usbalbin/hw-half-bridge/controller/controller.png

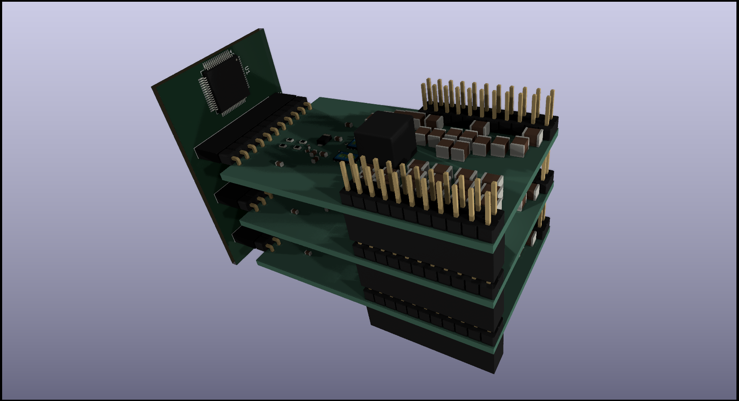
controller/controller.png
