usbalbin/hw-half-bridge/controller/controller2.png

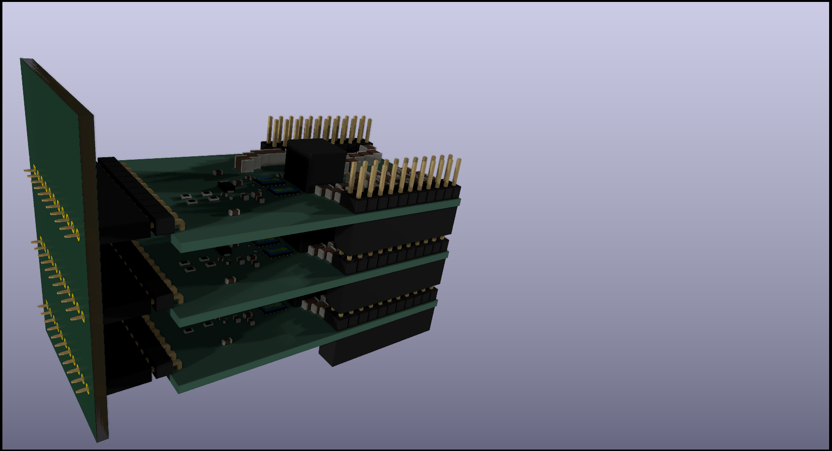
controller/controller2.png
