usbalbin/hw-half-bridge/3d/Alps/RK09Y11L0001.STEP

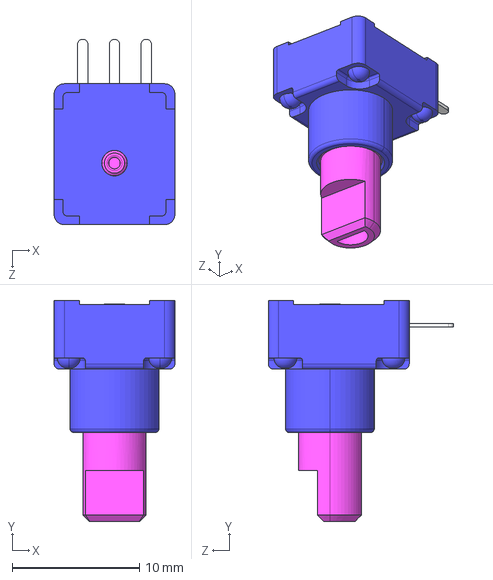
[picture p3: CAD file, 2024-12-15]
3d/Alps/RK09Y11L0001.STEP
9.50 x 17.4 x 14.6 mm
