usbalbin/hw-half-bridge/3d/Cree LED/CLMUD-FKC-CH1NP1561BB7T4S3.stp

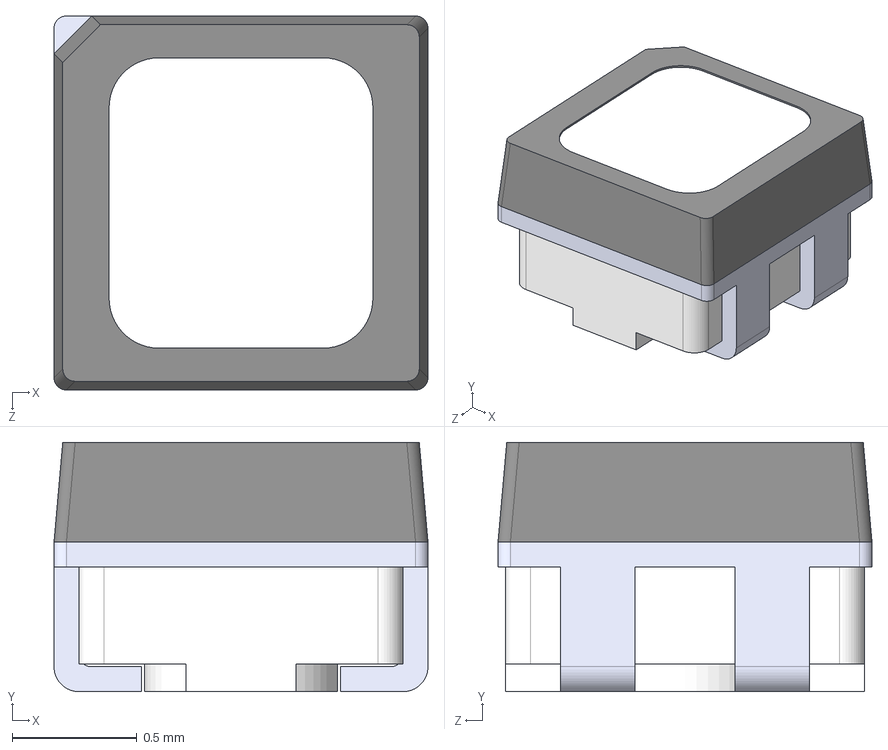
[picture p4: CAD file, 2024-12-15]
3d/Cree LED/CLMUD-FKC-CH1NP1561BB7T4S3.stp
1.50 x 1.00 x 1.50 mm
