usbalbin/hw-half-bridge/3d/kemet/C1210C474KARACAUTO.step

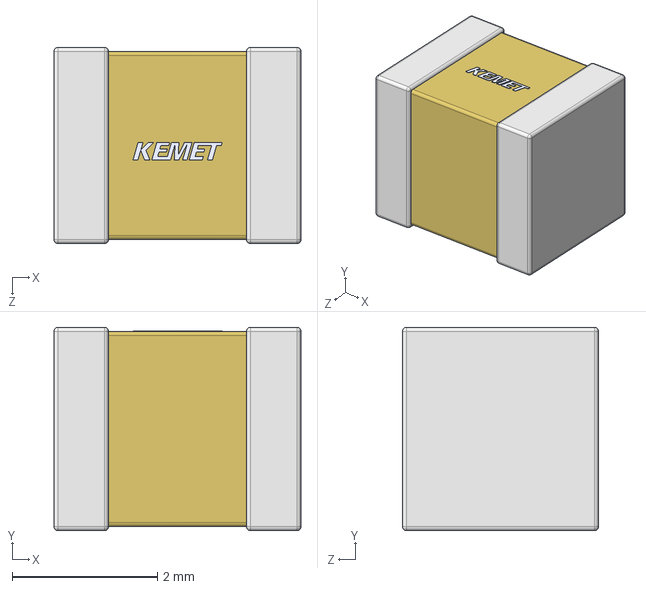
[picture p6: CAD file, 2024-06-02]
3d/kemet/C1210C474KARACAUTO.step
3.40 x 2.80 x 2.70 mm
