usbalbin/hw-half-bridge/3d/ohmite/FCSL20R005FER.stp

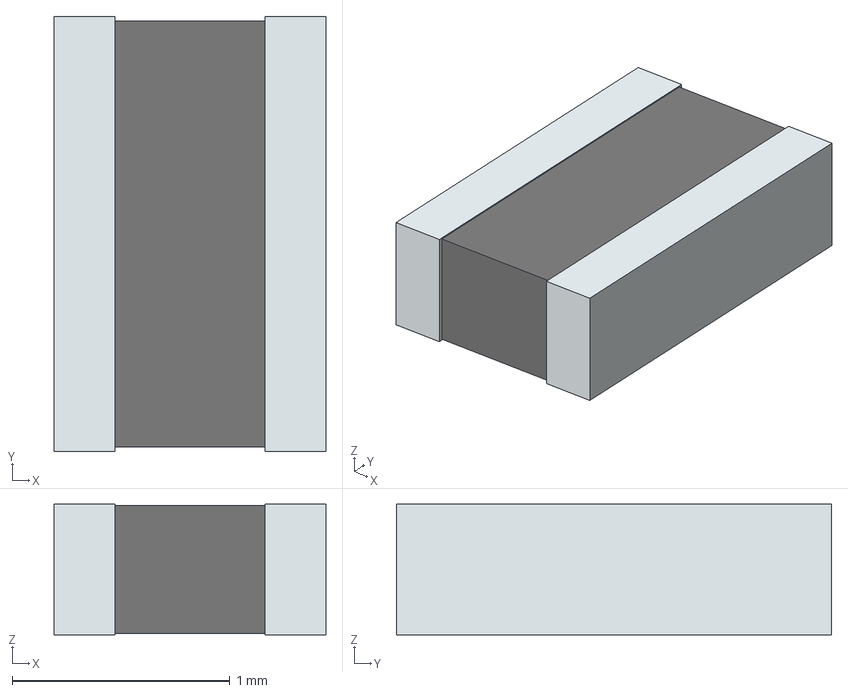
[picture p7: CAD file, 2024-06-02]
3d/ohmite/FCSL20R005FER.stp
1.25 x 2.00 x 0.6 mm
term1
term2
