usbalbin/hw-half-bridge/3d/STM/QFN-6L_STM.step

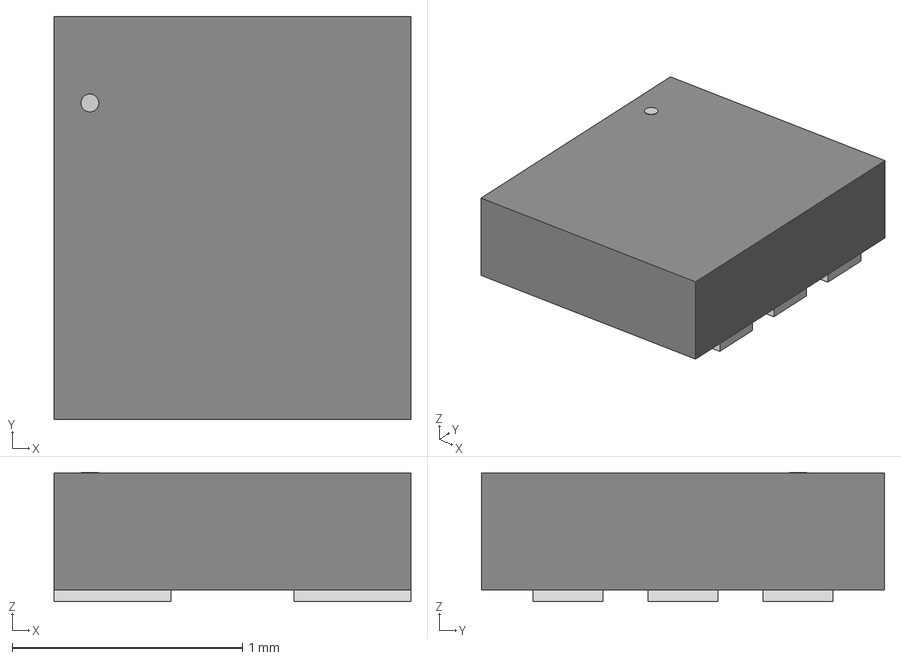
[picture p8: CAD file, 2024-12-15]
3d/STM/QFN-6L_STM.step
1.55 x 1.75 x 0.561 mm
