usbalbin/hw-half-bridge/3d/TDK/CLF7045NIT-4R7N-D.STEP

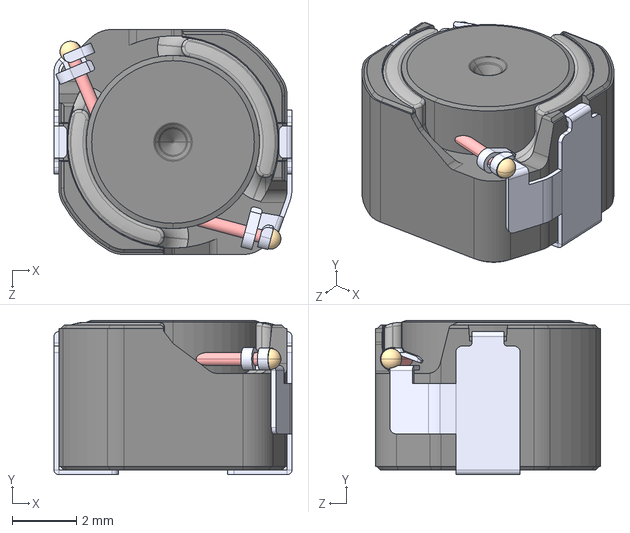
[picture p9: CAD file, 2024-12-15]
3d/TDK/CLF7045NIT-4R7N-D.STEP
7.40 x 4.80 x 7.00 mm
