usbalbin/hw-half-bridge/3d/texas/RVR0019A.stp

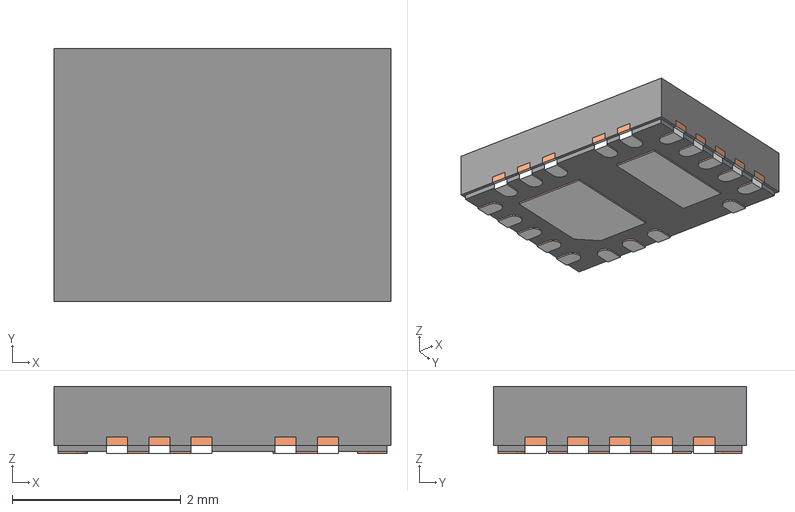
[picture p10: CAD file, 2024-06-02]
3d/texas/RVR0019A.stp
4.00 x 3.00 x 0.8 mm
BODY-QFN_AF0
FRAME-RVR0019A_AF0
PIN1-ID
