usbalbin/hw-half-bridge/heat-spreader/heat_spreader2.FCStd

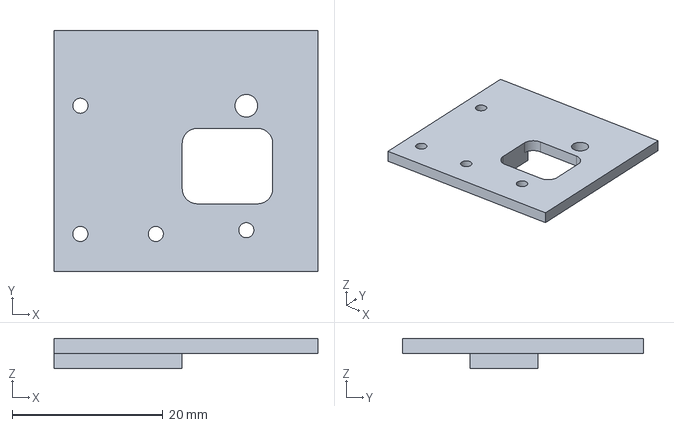
[picture p11: CAD file, 2025-07-12]
heat-spreader/heat_spreader2.FCStd
35.0 x 32.0 x 4.00 mm
