usbalbin/hw-half-bridge/3d/Alps/EC11E-05SW.STEP

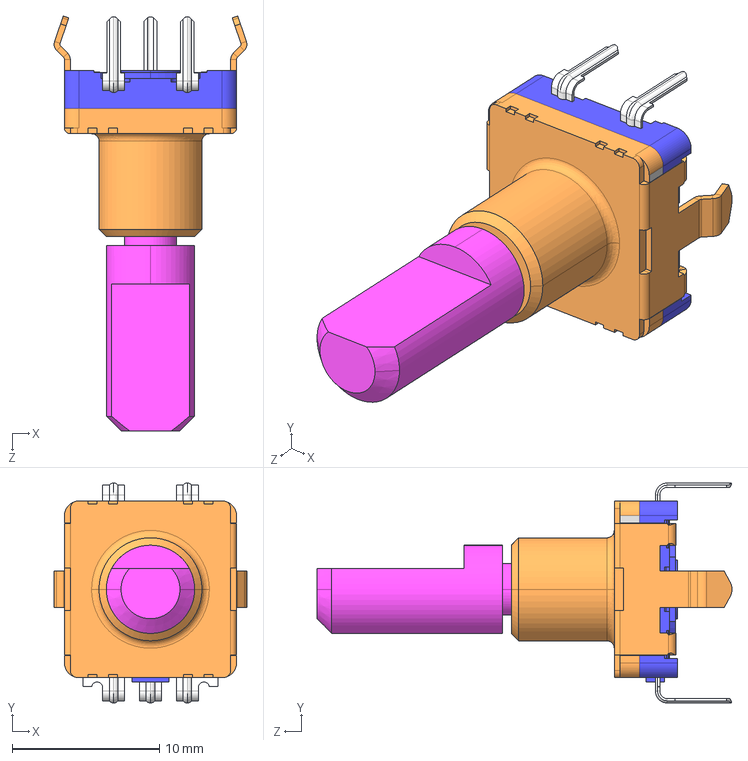
[picture p12: CAD file, 2024-12-15]
3d/Alps/EC11E-05SW.STEP
13.1 x 15.0 x 28.2 mm
