usbalbin/hw-half-bridge/heat-spreader/heat_spreader.FCStd

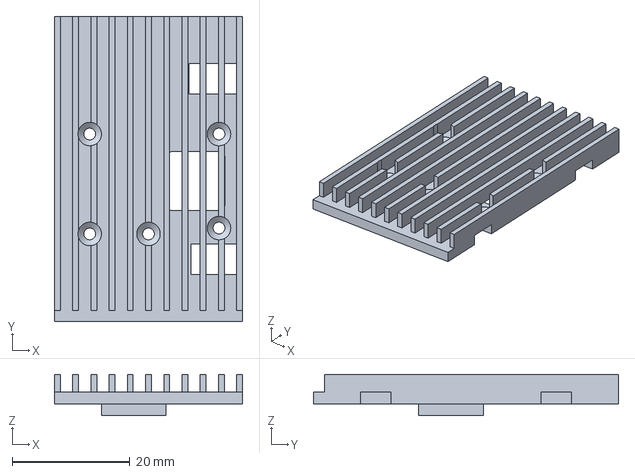
[picture p13: CAD file, 2024-06-02]
heat-spreader/heat_spreader.FCStd
32.0 x 51.9 x 7.00 mm
