usbalbin/hw-half-bridge/3d/Allegro/ACS37030LLZATR-020B3.stp

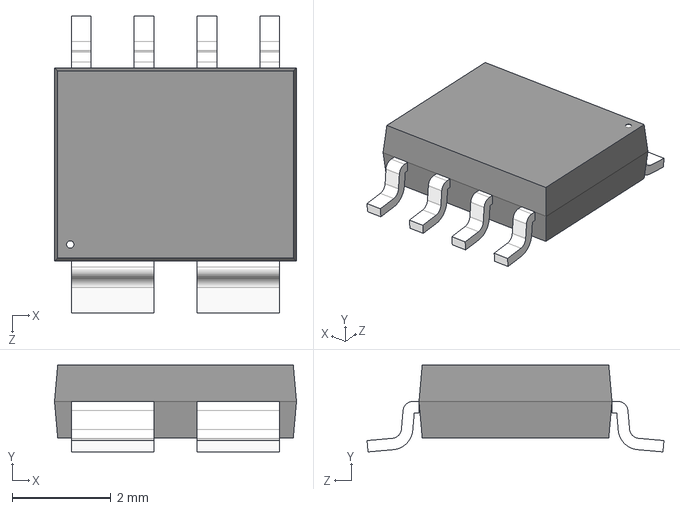
[picture p14: CAD file, 2024-12-15]
3d/Allegro/ACS37030LLZATR-020B3.stp
4.89 x 1.75 x 6.00 mm
