usbalbin/hw-half-bridge/(threads)

Thread 11 (2025-06-15):

Tests

usbalbin, 2025-06-15:
With 10ohm gate resistors

* f_sw: 1MHz (yes this should be reduced I know)
* t_dt: 21ns deadtime
* r_load: 4ohm load
* v_in: 20v
* D: ramping 20-90% "sawtooth" with about 10s period
* I_in max 3.2A at 90%
* Temp: high side FET hurts a bit to touch (camera says about 60). Will probably get too hot at constant 90%. You can feel the cange in temp during the ramp.

Looking at [EPC buck tool](https://epc-co.com/epc/design-support/tools-and-calculators/gan-power-bench/gan-fet-selection-tool-for-buck-convertors) the losses of the high side FET should be 459mW with 261mW being due to Poss. Reducing the gate resistors to 1ohm would in theory give us 375mW. Also the low side losses are more or less dominated by the deadtime losses.

TODO:
* [ ] Check gate wave forms
* [ ] How low can we go with the deadtime
* [ ] Ringing?
* [ ] Reduce gate resistors? 1ohm?
* [ ] Repeat

Test lower f_sw
Test lower r_load and lower v_in
