usbalbin/hw-half-bridge/controller/controller.kicad_pcb

## KiCad design controller/controller.kicad_pcb (2024-12-15)

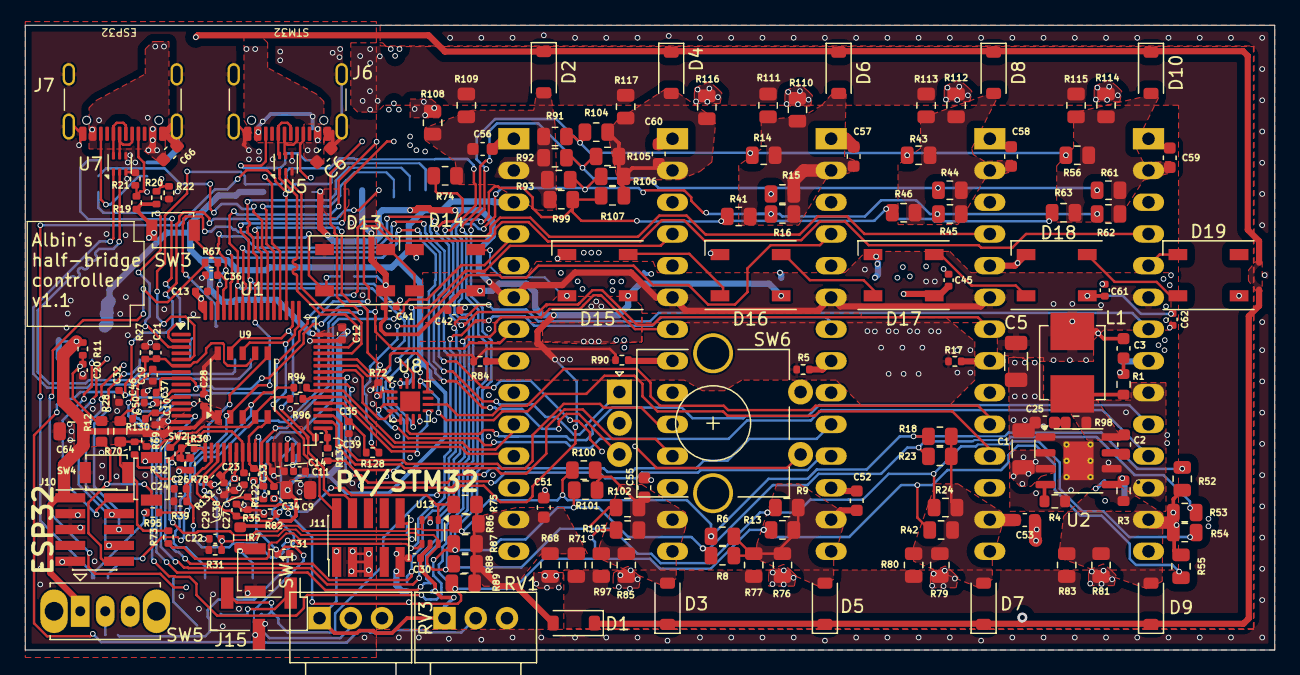
[picture p15: board controller.kicad_pcb from above]

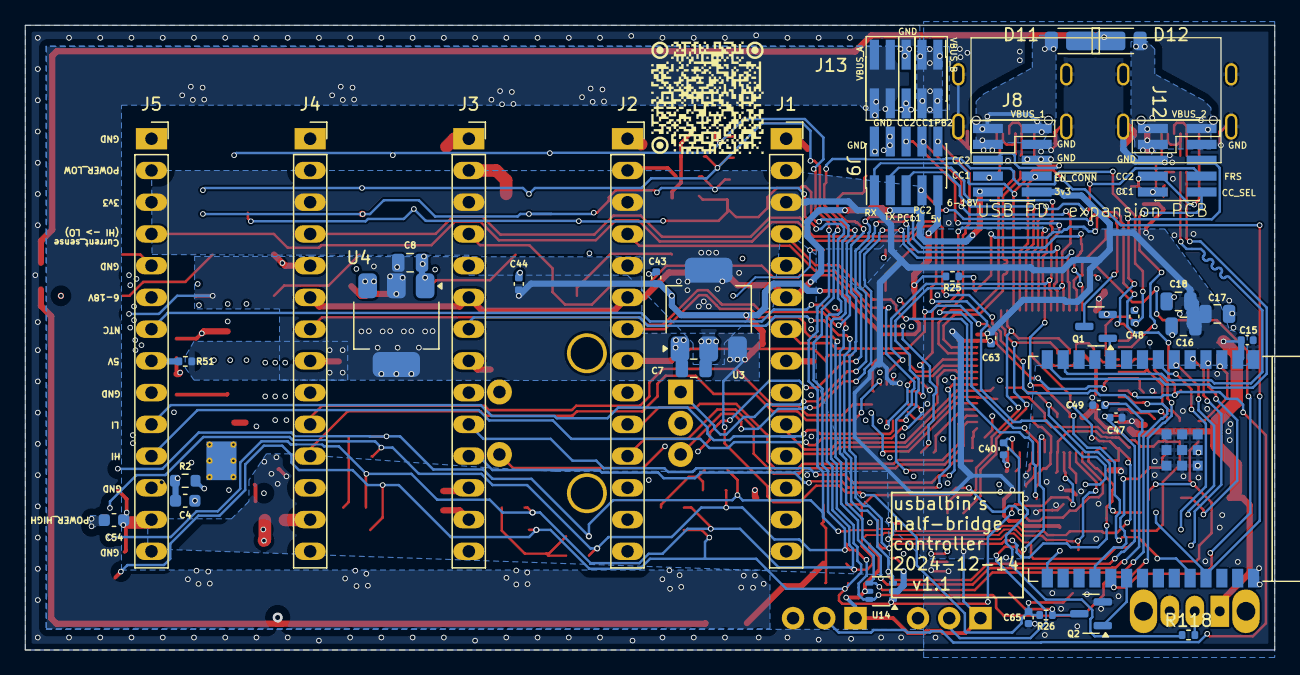
[picture p16: board controller.kicad_pcb from below]

Board: 4 copper layers, 100.0 x 50.0 mm, 225 parts (38 on the bottom side), 123 nets.

Parts:
C1: 2.2uF; C_1206_3216Metric
C2: 2.2nF; C_0603_1608Metric
C3: 1.2nF; C_0603_1608Metric
C4: 47pF; C_0603_1608Metric
C5: 4.7uF; C_1206_3216Metric
C6, C66: 2.2uF; C_0603_1608Metric
C7, C8, C9, C16, C17, C18, C64: 10uF; C_0805_2012Metric
C10, C11, C12, C13, C14, C15, C19, C20, C28, C41, C42, C43, C44, C45, C61, C62, C63, C65: 100nF; C_0402_1005Metric
C21, C22, C23, C24, C26, C27, C29, C31, C32, C34, C36, C40, C46, C47, C48, C49, C50: 10nF; C_0402_1005Metric
C25: ?; C_0603_1608Metric
C30: 1uF; C_0402_1005Metric
C33, C35, C37, C38, C39: ?pF; C_0402_1005Metric
C51, C52, C53, C54, C55, C56, C57, C58, C59, C60: 1nF 100VDC; C_0603_1608Metric
D1, D2, D3, D4, D5, D6, D7, D8, D9, D10: 1N4148W; D_SOD-123
D11, D12: DFLS1200; D_PowerDI-123
D13, D14, D15, D16, D17, D18, D19: WS2812B; LED_WS2812B_PLCC4_5.0x5.0mm_P3.2mm
J1, J2, J3, J4, J5: Conn_01x14; half_bridge_card
J6, J7: USB_C_Receptacle_USB2.0_16P; USB_C_Receptacle_GCT_USB4105-xx-A_16P_TopMnt_Horizontal
J8, J9, J12, J13: GRPB072VWQS-RC; PinHeader_2x05_P1.27mm_Vertical_SMD
J10, J11: Conn_ARM_JTAG_SWD_10; PinHeader_2x05_P1.27mm_Vertical_SMD
J15: Conn_01x03_Pin; PinHeader_1x03_P2.54mm_Vertical_SMD_Pin1Left
L1: duger CLF7045NIT-151M-D?; L_Murata_LQH55DN_5.7x5.0mm
Q1, Q2: BSS138; SOT-23
R1: 121k; R_0603_1608Metric
R2: 576k; R_0603_1608Metric
R3: 101k; R_0603_1608Metric
R4: 66.5k; R_0603_1608Metric
R5, R17, R30, R32, R51, R84, R90, R94, R95, R96: 0R; R_0402_1005Metric
R6, R8, R9, R13, R14, R15, R16, R18, R23, R24, R41, R42, R43, R44, R45, R46, R52, R53, R54, R55, R56, R61, R62, R63, R86, R87, R88, R89, R91, R92, R93, R99, R100, R101, R102, R103, R104, R105, R106, R107: ?R; R_0805_2012Metric
R7: 10k; R_0603_1608Metric
R11, R69, R72: 10k; R_0402_1005Metric
R12: 1k; R_0603_1608Metric
R19, R20, R21, R22: ?R; R_0402_1005Metric
R25, R26: ?k; R_0402_1005Metric
R27, R31, R35, R39, R78, R82: R_Small; R_0402_1005Metric
R28: 0R; R_0603_1608Metric
R67, R70, R73, R118, R122, R128, R130, R132, R134: 1k; R_0402_1005Metric
R68, R71, R74, R75, R76, R77, R79, R80, R81, R83, R85, R97, R108, R109, R110, R111, R112, R113, R114, R115, R116, R117: 0R; R_0805_2012Metric
R98: ?; R_0603_1608Metric
RV1, RV3: R_Potentiometer; Potentiometer_Alps_RK09Y11_Single_Horizontal
SW1, SW3: Boot; SW_SPST_B3U-1000P
SW2, SW4: Reset; SW_SPST_B3U-1000P
SW5: SW_Nidec_CAS-120A1; SW_Slide_SPDT_Straight_CK_OS102011MS2Q
SW6: EC11E15244G1; RotaryEncoder_Alps_EC11E-Switch_Vertical_H20mm_CircularMoun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
U1: STM32G474RCTx; LQFP-64_10x10mm_P0.5mm
U2: LM5169PDDAR; HSOP-8-1EP_3.9x4.9mm_P1.27mm_EP2.41x3.1mm_ThermalVias
U3: TLV76133DCY; SOT-223-3_TabPin2
U4: TLV76150DCY; SOT-223-3_TabPin2
U5, U7: ECMF02-2AMX6; ST_UQFN-6L_1.5x1.7mm_P0.5mm
U6: ESP32-C6-WROOM-1
U8: PI5C3257; TQFN-16-1EP_3x3mm_P0.5mm_EP1.6x1.6mm
U9: PY32F002AA15M; SSOP-10_3.9x4.9mm_P1.00mm
U13, U14: QSBT40-7-F; SOT-363_SC-70-6

Connections:
6-18V: C3.1, C5.1, J1.6, J2.6, J3.6, J4.6, J5.6, J8.9, L1.2, R2.1, U4.3 (VI)
+3V3: C7.1, C9.1, C10.1, C11.1, C12.1, C13.1, C14.1, C15.1, C16.1, C17.1, C18.1, C28.1, C30.2, C63.1, C64.1, J1.3, J2.3, J3.3, J4.3, J5.3, J8.10, J10.1 (VTref), J11.1 (VTref), R7.1, R11.1, R19.1, R20.1, R69.1, RV1.1, RV3.1, SW3.1, SW5.1 (C), U1.16 (VDD), U1.28 (VREF+), U1.29 (VDDA), U1.32 (VDD), U1.48 (VDD), U1.64 (VDD), U3.2 (VO), U6.2 (3V3), U8.16 (VCC), U9.1, U13.5 (VCC), U14.5 (VCC)
+5V: C8.1, C41.1, C42.1, C43.1, C44.1, C45.1, C61.1, C62.1, C65.1, D13.1 (VDD), D14.1 (VDD), D15.1 (VDD), D16.1 (VDD), D17.1 (VDD), D18.1 (VDD), D19.1 (VDD), J9.9, J15.3, R5.2, R17.2, R25.2, R26.2, R51.2, R84.2, R90.2, U3.3 (VI), U4.2 (VO)
/CC1: J6.A5 (CC1), J8.7
/CC1_MCU: J9.8, U1.59 (PB6), U8.5 (I0b)
/CC2: J6.B5 (CC2), J8.5
/CC2_MCU: J9.6, U1.57 (PB4), U8.14 (I0c)
/CC_HI4_HI5_MUX: R72.2, U1.55 (PD2), U8.1 (S)
/CC_SELECT: J12.10, U1.3 (PC14)
/Current_sense_1: C33.1, R122.1, U1.24 (PB0), U9.5
/Current_sense_2: C39.1, R134.1, U1.33 (PB11)
/Current_sense_3: C35.1, R128.1, U1.36 (PB14)
/Current_sense_4: C37.1, R130.1, U1.13 (PA1)
/Current_sense_5: C38.1, R132.1, U1.21 (PA7)
/ESP_USB_D+: U6.14 (GPIO13/USB_D+), U7.1 (D_IN+)
/ESP_USB_D-: U6.13 (GPIO12/USB_D-), U7.2 (D_IN-)
/FRS: J12.8, U1.54 (PC12)
/HI_1: J1.11, R96.2, U1.38 (PC6)
/HI_2: J2.11, U1.34 (PB12)
/HI_3: J3.11, U1.40 (PC8)
/LED_CH1: D13.4 (DIN), Q1.3 (D), R25.1
/LED_CH2: J15.1, Q2.3 (D), R26.1
/LI_1: J1.10, R94.1, U1.39 (PC7)
/LI_2: J2.10, U1.35 (PB13)
/LI_3: J3.10, U1.41 (PC9)
/NTC_1: C46.1, J1.7, U1.8 (PC0)
/NTC_2: C50.1, J2.7, U1.11 (PC3), U14.4 (DL2)
/NTC_3: C47.1, J3.7, U1.14 (PA2), U14.3 (DL3)
/NTC_4: C48.1, J4.7, U1.5 (PF0)
/NTC_5: C49.1, J5.7, U1.12 (PA0)
/OTHER_USB_CC1: J7.A5 (CC1), J12.9, R19.2, R21.1
/OTHER_USB_CC2: J7.B5 (CC2), J12.7, R20.2, R22.1
/PA4: C24.1, R39.1, R74.2, U1.18 (PA4), U13.4 (DL2)
/PA5: C27.1, R75.2, R82.1, U1.19 (PA5), U13.1 (DL4)
/PA8: U1.42 (PA8), U8.4 (Za)
/PA9: U1.43 (PA9), U8.7 (Zb)
/PA10: U1.44 (PA10), U8.12 (Zc)
/PB2: C34.1, J9.10, U1.26 (PB2)
/PB15: U1.37 (PB15), U8.9 (Zd)
/PC2: C32.1, J9.7, RV1.2, U1.10 (PC2)
/PC11: J9.5, U1.53 (PC11)
/POWER_BTN: C40.1, R118.1, U1.30 (PB10)
/STM32_BOOT0: R67.2, U6.19 (GPIO21)
/STM32_NRST: R28.1, R69.2, R70.2, R73.2, R96.1, SW4.1, U9.4
/STM32_NRST_TO_CON: J11.10 (~RESET), R73.1
/STM32_NRST_TO_ESP: R70.1, U6.18 (GPIO20)
/STM32_RX: J9.1, R95.1, U1.51 (PA15), U6.25 (U0TXD/GPIO16)
/STM32_SWC: J11.4 (SWCLK/TCK), U1.50 (PA14), U9.9
/STM32_SWDIO: J11.2 (SWDIO/TMS), U1.49 (PA13), U9.8
/STM32_TX: J9.3, U1.56 (PB3), U6.24 (U0RXD/GPIO17), U9.2
/VBUS1: C6.1, D11.2 (A), J6.A4 (VBUS), J6.A9 (VBUS), J6.B4 (VBUS), J6.B9 (VBUS), J8.1, J8.2, J8.3
/VBUS2: C66.1, D12.2 (A), J7.A4 (VBUS), J7.A9 (VBUS), J7.B4 (VBUS), J7.B9 (VBUS), J12.1, J12.2, J12.3
/esp32c6/LED_CH1: Q1.1 (G), U6.10 (GPIO8)
/esp32c6/LED_CH2: Q2.1 (G), U6.20 (GPIO22)
/hb-card1/Current_sense: J1.4, R122.2
/hb-card1/FB_x_FULL_HI: C51.1, D1.2 (A), J1.13, R68.1, R71.1, R75.1, R86.1, R87.1, R88.1, R89.1
/hb-card1/FB_x_FULL_LO: C56.1, D2.2 (A), J1.2, R74.1, R91.1, R92.1, R93.1, R99.1, R108.1, R109.1
/hb-card2/Current_sense: J2.4, R134.2
/hb-card2/FB_x_FULL_HI: C55.1, D3.2 (A), J2.13, R85.1, R97.1, R100.1, R101.1, R102.1, R103.1
/hb-card2/FB_x_FULL_LO: C60.1, D4.2 (A), J2.2, R104.1, R105.1, R106.1, R107.1, R116.1, R117.1
/hb-card3/Current_sense: J3.4, R128.2
/hb-card3/FB_x_FULL_HI: C52.1, D5.2 (A), J3.13, R6.1, R8.1, R9.1, R13.1, R76.1, R77.1
/hb-card3/FB_x_FULL_LO: C57.1, D6.2 (A), J3.2, R14.1, R15.1, R16.1, R41.1, R110.1, R111.1
/hb-card4/Current_sense: J4.4, R130.2
/hb-card4/FB_x_FULL_HI: C53.1, D7.2 (A), J4.13, R18.1, R23.1, R24.1, R42.1, R79.1, R80.1
/hb-card4/FB_x_FULL_LO: C58.1, D8.2 (A), J4.2, R43.1, R44.1, R45.1, R46.1, R112.1, R113.1
/hb-card5/Current_sense: J5.4, R132.2
/hb-card5/FB_x_FULL_HI: C54.1, D9.2 (A), J5.13, R52.1, R53.1, R54.1, R55.1, R81.1, R83.1
/hb-card5/FB_x_FULL_LO: C59.1, D10.2 (A), J5.2, R56.1, R61.1, R62.1, R63.1, R114.1, R115.1
/pwm_led1: SW6.A, U1.58 (PB5)
/pwm_led2: SW6.B, U1.60 (PB7)
/pwm_led3: SW6.S1, U1.62 (PB9)
/pwm_led4: R7.2, SW1.1, U6.15 (GPIO9)
/pwm_led5 pot2: R30.1, U1.17 (PA3)
/pwm_led6 pot3: C31.1, RV3.2, U1.25 (PB1)
/pwm_led7: C29.1, R32.1, U1.23 (PC5)
/~EN_CC: J12.6, U1.2 (PC13)
/~EN_VCONN: J8.8, U1.52 (PC10)
Earth: C1.2, C5.2, C6.2, C7.2, C8.2, C9.2, C10.2, C11.2, C12.2, C13.2, C14.2, C15.2, C16.2, C17.2, C18.2, C19.2, C20.2, C21.2, C22.2, C23.2, C24.2, C25.2, C26.2, C27.2, C28.2, C29.2, C30.1, C31.2, C32.2, C33.2, C34.2, C35.2, C36.2, C37.2, C38.2, C39.2, C40.2, C41.2, C42.2, C43.2, C44.2, C45.2, C46.2, C47.2, C48.2, C49.2, C50.2, C51.2, C52.2, C53.2, C54.2, C55.2, C56.2, C57.2, C58.2, C59.2, C60.2, C61.2, C62.2, C63.2, C64.2, C65.2, C66.2, D13.3 (VSS), D14.3 (VSS), D15.3 (VSS), D16.3 (VSS), D17.3 (VSS), D18.3 (VSS), D19.3 (VSS), J1.1, J1.5, J1.9, J1.12, J1.14, J2.1, J2.5, J2.9, J2.12, J2.14, J3.1, J3.5, J3.9, J3.12, J3.14, J4.1, J4.5, J4.9, J4.12, J4.14, J5.1, J5.5, J5.9, J5.12, J5.14, J6.A1 (GND), J6.A12 (GND), J6.B1 (GND), J6.B12 (GND), J6.S1 (SHIELD), J7.A1 (GND), J7.A12 (GND), J7.B1 (GND), J7.B12 (GND), J7.S1 (SHIELD), J8.4, J8.6, J9.2, J9.4, J10.3 (GND), J10.5 (GND), J10.9 (GNDDetect), J11.3 (GND), J11.5 (GND), J11.9 (GNDDetect), J12.4, J12.5, J13.5, J13.6, J15.2, Q1.2 (S), Q2.2 (S), R3.2, R4.2, R21.2, R22.2, R27.2, R31.2, R35.2, R39.2, R72.1, R78.2, R82.2, RV1.3, RV3.3, SW1.2, SW2.2, SW4.2, SW5.3 (A), SW6.C, SW6.MP, SW6.S2, U1.15 (VSS), U1.27 (VSSA), U1.31 (VSS), U1.47 (VSS), U1.63 (VSS), U2.1 (GND), U2.6 (PGOOD), U2.9 (EP), U3.1 (GND), U4.1 (GND), U5.3 (GND), U5.4 (NC), U6.1 (GND), U6.28 (GND), U6.29 (GND), U7.3 (GND), U7.4 (NC), U8.8 (GND), U8.15 (OE), U9.10, U13.2 (GND), U14.2 (GND)
FB_A_FULL: C26.1, R6.2, R14.2, R18.2, R30.2, R32.2, R43.2, R52.2, R56.2, R78.1, R86.2, R91.2, R100.2, R104.2, U9.6, U13.3 (DL3)
FB_B_FULL: C21.1, R8.2, R15.2, R23.2, R27.1, R44.2, R53.2, R61.2, R87.2, R92.2, R101.2, R105.2, U1.6 (PF1), U9.7, U14.6 (DL1)
FB_C_FULL: C22.1, R9.2, R16.2, R24.2, R31.1, R45.2, R54.2, R62.2, R88.2, R93.2, R102.2, R106.2, U1.20 (PA6), U13.6 (DL1)
FB_D_FULL: C23.1, R13.2, R35.1, R41.2, R42.2, R46.2, R55.2, R63.2, R89.2, R99.2, R103.2, R107.2, U1.22 (PC4), U14.1 (DL4)
HI_4: J4.11, U8.13 (I1c)
HI_5: J5.11, U8.3 (I1a)
LI_4: J4.10, U8.10 (I1d)
LI_5: J5.10, U8.6 (I1b)
Logic DC/DC in: C1.1, D1.1 (K), D2.1 (K), D3.1 (K), D4.1 (K), D5.1 (K), D6.1 (K), D7.1 (K), D8.1 (K), D9.1 (K), D10.1 (K), D11.1 (K), D12.1 (K), U2.2 (VIN), U2.3 (EN/UVLO)
unnamed: C3.2, C4.1, R1.2
unnamed: C25.1, R98.2
unnamed: D13.2 (DOUT), D14.4 (DIN)
unnamed: D14.2 (DOUT), D15.4 (DIN)
unnamed: D15.2 (DOUT), D16.4 (DIN)
unnamed: D16.2 (DOUT), D17.4 (DIN)
unnamed: D17.2 (DOUT), D18.4 (DIN)
unnamed: D18.2 (DOUT), D19.4 (DIN)
unnamed: J1.8, R84.1
unnamed: J2.8, R90.1
unnamed: J3.8, R5.1
unnamed: J4.8, R17.1
unnamed: J5.8, R51.1
unnamed: J10.8 (NC/TDI), U6.5 (MTDI/GPIO5/ADC1_CH5)
unnamed: J10.4 (SWCLK/TCK), U6.6 (MTCK/GPIO6/ADC1_CH6)
unnamed: J10.2 (SWDIO/TMS), U6.4 (MTMS/GPIO4/ADC1_CH4)
unnamed: J10.6 (SWO/TDO), U6.7 (MTDO/GPIO7)
unnamed: J10.10 (~RESET), R12.2, SW2.1
unnamed: R118.2, SW5.2 (B)
unnamed: C36.1, R67.1, SW3.2, U1.61 (PB8)
unnamed: C19.1, R28.2, U1.7 (PG10)
unnamed: C2.1, U2.7 (BST)
unnamed: C4.2, R2.2, R3.1, U2.5 (FB)
unnamed: R4.1, U2.4 (RON)
unnamed: C2.2, L1.1, R1.1, R98.1, U2.8 (SW)
unnamed: J6.A6 (D+), J6.B6 (D+), U5.6 (D_OUT+)
unnamed: J6.A7 (D-), J6.B7 (D-), U5.5 (D_OUT-)
unnamed: C20.1, R11.2, R12.1, U6.3 (EN/CHIP_PU)
unnamed: J7.A6 (D+), J7.B6 (D+), U7.6 (D_OUT+)
unnamed: J7.A7 (D-), J7.B7 (D-), U7.5 (D_OUT-)
unnamed: R94.2, R95.2, U9.3
USB_D+: U1.46 (PA12), U5.1 (D_IN+)
USB_D-: U1.45 (PA11), U5.2 (D_IN-)
VBUS_A: J13.7, J13.8, J13.9, J13.10, R68.2, R76.2, R79.2, R81.2, R85.2, R108.2, R110.2, R112.2, R114.2, R116.2
VBUS_B: J13.1, J13.2, J13.3, J13.4, R71.2, R77.2, R80.2, R83.2, R97.2, R109.2, R111.2, R113.2, R115.2, R117.2
