usbalbin/hw-half-bridge/half-bridge/half-bridge.kicad_pcb

## KiCad design half-bridge/half-bridge.kicad_pcb (2024-12-15)

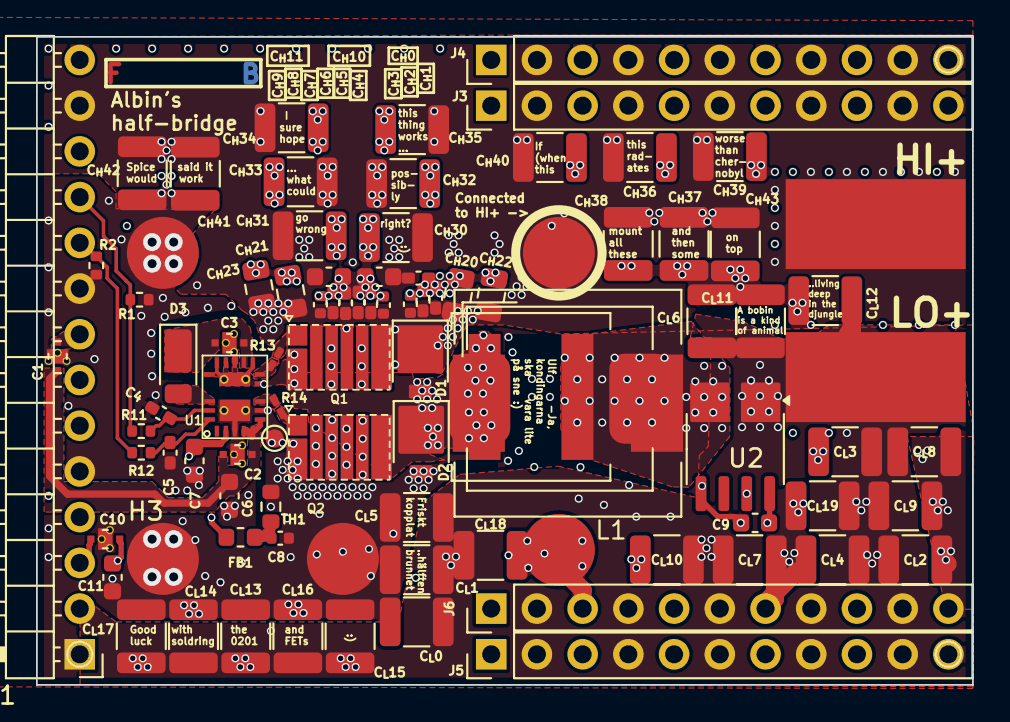
[picture p17: board half-bridge.kicad_pcb from above]

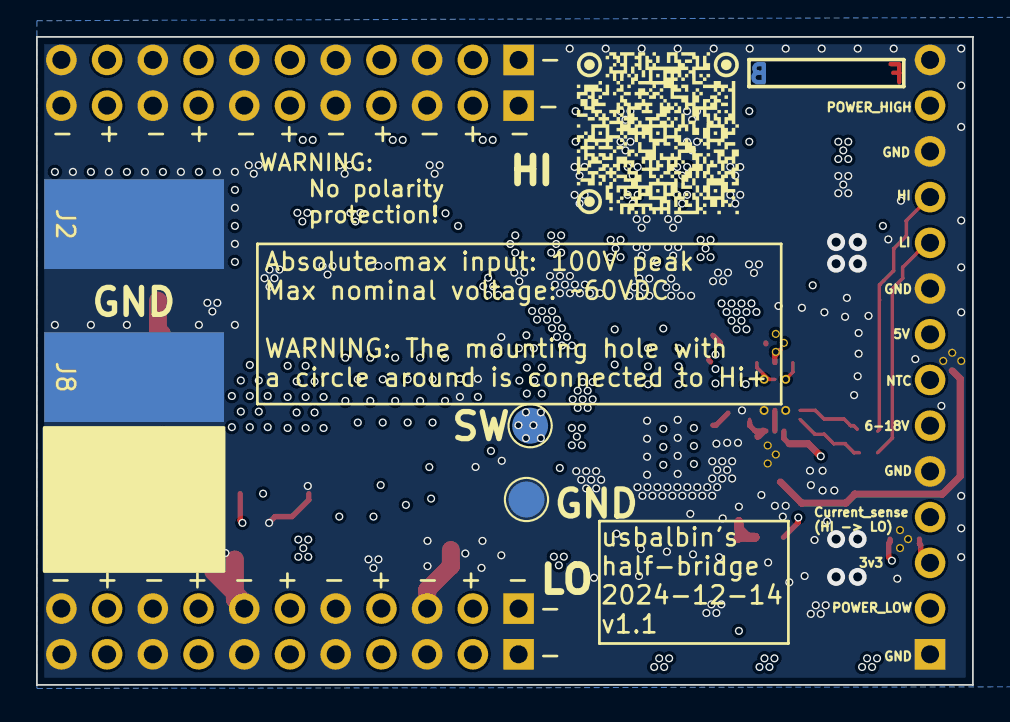
[picture p18: board half-bridge.kicad_pcb from below]

Board: 8 copper layers, 52.0 x 36.0 mm, 99 parts (4 on the bottom side), 23 nets.

Parts:
C1, C2, C3, C10: YFF18PW0J474M; C_0603_1608Metric_Feedthrough_W_0.45Vias
C4, C5: ?pF; C_0402_1005Metric_Pad0.74x0.62mm_HandSolder
C6, C7, C11: 10u; C_0603_1608Metric
C8: 100nF; C_0402_1005Metric
C9: C_Small; C_0603_1608Metric
C_{H}0, C_{H}1, C_{H}2, C_{H}5, C_{H}6, C_{H}7, C_{H}8: cap=64nF esr=16.09m srf=17.58MEG; C_0402_1005Metric_Pad0.74x0.62mm_HandSolder
C_{H}3, C_{H}4, C_{H}9: cap=64nF esr=16.09m srf=17.58MEG; C_0402_1005Metric
C_{H}10, C_{H}11: cap=64nF esr=16.09m srf=17.58MEG; C_0603_1608Metric
C_{H}20, C_{H}21, C_{H}22: 10nF; C_0805_2012Metric
C_{H}23: cap=10nF esr=26.96 srf=43.8; C_0805_2012Metric
C_{H}30, C_{H}31, C_{H}32, C_{H}33, C_{H}34, C_{H}35, C_{H}36, C_{H}37, C_{H}38, C_{H}39, C_{H}40, C_{H}41, C_{H}42, C_{H}43: 10uF; C_1210_3225Metric
C_{L}0, C_{L}1, C_{L}2, C_{L}3, C_{L}4, C_{L}5, C_{L}6, C_{L}7, C_{L}8, C_{L}9, C_{L}10, C_{L}11, C_{L}12, C_{L}13, C_{L}14, C_{L}15, C_{L}16, C_{L}17, C_{L}18, C_{L}19: 10uF; C_1210_3225Metric
D1, D2: D_Schottky; D_SMP_DO-220AA
D3: DFLS1200; D_PowerDI-123
FB1: FerriteBead; L_0603_1608Metric
FID1, FID2, FID3: Fiducial; TestPoint_Pad_D1.0mm
H1, H2, H3, H4, H5: WE 97730256330; Mounting_Wuerth_WA-SMSI-M1.6_H2.5mm_ThreadDepth1.5mm_NoNPTH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
J1: Conn_01x14; PinHeader_1x14_P2.54mm_Horizontal
J2, J7, J8, J9: MountingHole_Pad; SolderWirePad_1x01_SMD_5x10mm
J3, J4, J5, J6: Conn_01x11_Pin; PinHeader_1x11_P2.54mm_Vertical
L1: ind=1.76uH esr=9.77m epc=9.28pF; L_Coilcraft_XAL8080-XXX
L4: L_Wuerth_WE-PD-Typ-LS
L5: L_Bourns_SRP1050WA
Q1, Q2: EPC2306; EPC PQFN 3x5 mm
R1, R2: 10k; R_0402_1005Metric
R11, R12: 100R; R_0402_1005Metric
R13, R14: 2R; R_0201_0603Metric_Pad0.64x0.40mm_HandSolder
TH1: Thermistor_NTC; R_0603_1608Metric
TP1, TP2: TestPoint; TestPoint_Pad_D2.0mm
TP3: TestPoint; TestPoint_Pad_D1.0mm
U1: LMG1210; lmg1210
U2: ACS37030; ACS3703x

Connections:
0: C1.2, C2.2, C4.2, C5.2, C6.2, C7.2, C8.2, C9.1, C10.2, C11.2, C_{H}0.2, C_{H}1.2, C_{H}2.2, C_{H}3.2, C_{H}4.2, C_{H}5.2, C_{H}6.2, C_{H}7.2, C_{H}8.2, C_{H}9.2, C_{H}10.2, C_{H}11.2, C_{H}20.2, C_{H}21.2, C_{H}22.2, C_{H}23.2, C_{H}30.2, C_{H}31.2, C_{H}32.2, C_{H}33.2, C_{H}34.2, C_{H}35.2, C_{H}36.2, C_{H}37.2, C_{H}38.2, C_{H}39.2, C_{H}40.2, C_{H}41.2, C_{H}42.2, C_{H}43.2, C_{L}0.2, C_{L}1.2, C_{L}2.2, C_{L}3.2, C_{L}4.2, C_{L}5.2, C_{L}6.2, C_{L}7.2, C_{L}8.2, C_{L}9.2, C_{L}10.2, C_{L}11.2, C_{L}12.2, C_{L}13.2, C_{L}14.2, C_{L}15.2, C_{L}16.2, C_{L}17.2, C_{L}18.2, C_{L}19.2, D2.2 (A), H1.1, H3.1, H4.1, H5.1, J1.1, J1.5, J1.9, J1.12, J1.14, J2.1, J3.1, J3.3, J3.5, J3.7, J3.9, J3.11, J4.1, J4.3, J4.5, J4.7, J4.9, J4.11, J5.1, J5.3, J5.5, J5.7, J5.9, J5.11, J6.1, J6.3, J6.5, J6.7, J6.9, J6.11, J8.1, Q2.2 (S), Q2.4 (S), Q2.6 (S), R1.1, R2.1, TH1.2, TP2.1, TP3.1, U1.3 (Vss), U1.7 (Vss), U1.20 (Vss), U2.3 (GND)
6-18V: C7.1, J1.6, U1.2 (Vin)
+3V3: C9.2, C10.3, C11.1, U2.6 (VDD)
+5V: C1.3, C2.1, C2.3, C6.1, U1.4 (Vdd), U1.5 (DHL), U1.6 (DLH)
/HI: J1.11, R1.2, R11.1
/HO: R13.1, U1.10 (HO)
/I_Shunt: L1.2, L4.2, L5.2, U2.2 (IP-)
/LI: J1.10, R2.2, R12.1
/LO: R14.1, U1.8 (LO)
Current_sense: J1.4, U2.5 (VOUT)
Gate_hi: Q1.1 (G), R13.2
Gate_lo: Q2.1 (G), R14.2
NTC: FB1.1, J1.7
unnamed: C8.1, FB1.2, TH1.1
unnamed: D3.2 (A), U1.17 (BST)
unnamed: C3.1, C3.3, D3.1 (K), U1.12 (HB)
unnamed: C10.1, J1.3
unnamed: C1.1, J1.8
unnamed: C4.1, R11.2, U1.18 (EN/HI)
unnamed: C5.1, R12.2, U1.19 (PWM/LO)
POWER_HIGH: C_{H}0.1, C_{H}1.1, C_{H}2.1, C_{H}3.1, C_{H}4.1, C_{H}5.1, C_{H}6.1, C_{H}7.1, C_{H}8.1, C_{H}9.1, C_{H}10.1, C_{H}11.1, C_{H}20.1, C_{H}21.1, C_{H}22.1, C_{H}23.1, C_{H}30.1, C_{H}31.1, C_{H}32.1, C_{H}33.1, C_{H}34.1, C_{H}35.1, C_{H}36.1, C_{H}37.1, C_{H}38.1, C_{H}39.1, C_{H}40.1, C_{H}41.1, C_{H}42.1, C_{H}43.1, D1.1 (K), H2.1, J1.13, J3.2, J3.4, J3.6, J3.8, J3.10, J4.2, J4.4, J4.6, J4.8, J4.10, J7.1, Q1.3 (D), Q1.5 (D), Q1.7 (D)
POWER_LOW: C_{L}0.1, C_{L}1.1, C_{L}2.1, C_{L}3.1, C_{L}4.1, C_{L}5.1, C_{L}6.1, C_{L}7.1, C_{L}8.1, C_{L}9.1, C_{L}10.1, C_{L}11.1, C_{L}12.1, C_{L}13.1, C_{L}14.1, C_{L}15.1, C_{L}16.1, C_{L}17.1, C_{L}18.1, C_{L}19.1, J1.2, J5.2, J5.4, J5.6, J5.8, J5.10, J6.2, J6.4, J6.6, J6.8, J6.10, J9.1, U2.1 (IP+)
Switch_node: C3.2, D1.2 (A), D2.1 (K), L1.1, L4.1, L5.1, Q1.2 (S), Q1.4 (S), Q1.6 (S), Q2.3 (D), Q2.5 (D), Q2.7 (D), TP1.1, U1.9 (HS), U1.11 (HS), U1.13 (HS), U1.14 (HS), U1.15 (HS), U1.16 (HS), U1.21 (HS)
