usbalbin/hw-half-bridge/(commit log)

2023-11-12 Redo for kicad 7.0 stable
    [half-bridge.kicad_pcb, half-bridge.kicad_sch, hw-half-bridge.kicad_pcb, hw-half-bridge.kicad_sch]
2023-11-14 More work mainly on layout
    [half-bridge.kicad_pcb, half-bridge.kicad_sch]
2023-11-15 Use kicad 7.0
2024-06-02 Some changes
    [half-bridge.kicad_pcb, half-bridge.kicad_sch]
2024-06-02 Add drc rules and fix some errors
    [half-bridge.kicad_pcb]
2024-06-02 Start adding inductor current sense, adjust some vias and add input filtering
    [half-bridge.kicad_pcb, half-bridge.kicad_sch]
2024-06-02 More work on current sense
    [half-bridge.kicad_pcb, half-bridge.kicad_sch]
2024-06-02 More work on layout
    [half-bridge.kicad_pcb, half-bridge.kicad_sch]
2024-06-02 More work on layout for current signals
    [half-bridge.kicad_pcb, half-bridge.kicad_sch]
2024-06-02 Add footprints for feedthrough cap and 'heatsink'
2024-06-02 More cap
    [half-bridge.kicad_pcb, half-bridge.kicad_sch]
2024-06-02 Some improvements
    [half-bridge.kicad_pcb, half-bridge.kicad_sch]
2024-06-02 One gnd
    [half-bridge.kicad_pcb, half-bridge.kicad_sch]
2024-06-02 More changes, start work on simulating things
    [half-bridge.kicad_pcb, half-bridge.kicad_sch]
2024-06-02 Test EPC gan fet
    [half-bridge.kicad_pcb, half-bridge.kicad_sch]
2024-06-02 Sim changes
    [half-bridge.kicad_sch]
2024-06-02 More sim changes
    [half-bridge.kicad_sch]
2024-06-02 Lots of changes
    * Add smaller fast caps for input decoupling
    * Route current sense
    * Make footprint for more FETs. Still not sure which one to pick...
    * Controller board will be left of pcb stack stack instead of on top - no need for 0ohms to route signals
    * Some sim changes
    [half-bridge.kicad_pcb, half-bridge.kicad_sch]
2024-06-02 Add controller
    [controller.kicad_pcb, controller.kicad_sch]
2024-06-02 Add pin sockets
    [half-bridge.kicad_pcb, half-bridge.kicad_sch]
2024-06-02 Update kibot config for kicad 8
2024-06-02 Try to move closer to what EPC calls 'Optimal layout'
    [half-bridge.kicad_pcb, half-bridge.kicad_sch]
2024-06-02 Further layout improvements
    [half-bridge.kicad_pcb, half-bridge.kicad_sch]
2024-06-02 Clean up overlapping vias and zones
    [half-bridge.kicad_pcb, half-bridge.kicad_sch]
2024-06-02 More changes
    [half-bridge.kicad_pcb, half-bridge.kicad_sch]
2024-06-02 Add lib
    [D0606F.step, RVR0019A.stp]
2024-06-02 Add heat-spreader
    [heat_spreader.FCStd]
2024-06-02 Add some more small cap
    [half-bridge.kicad_pcb, half-bridge.kicad_sch]
2024-06-02 Add NTC
    [half-bridge.kicad_pcb, half-bridge.kicad_sch]
2024-06-02 Add diodes and make room for larger inductors
    [half-bridge.kicad_pcb, half-bridge.kicad_sch]
2024-06-02 Add current sense resistors
    [half-bridge.kicad_pcb, half-bridge.kicad_sch]
2024-06-02 Footprint - Add R_0508
2024-06-02 Cleanup most DRC errors
    [half-bridge.kicad_pcb, half-bridge.kicad_sch]
2024-06-02 Some improvements to gate loop
    [half-bridge.kicad_pcb]
2024-06-02 Change paths to 3d models
    [half-bridge.kicad_pcb]
2024-06-02 Change more paths to 3d models
    [half-bridge.kicad_pcb]
2024-06-02 Add some step files
    [C1210C474KARACAUTO.step, FCSL20R005FER.stp]
2024-06-02 Slightly increase POWER_HIGH area
    [half-bridge.kicad_pcb]
2024-06-02 Increase POWER_HIGH area further
    [half-bridge.kicad_pcb, half-bridge.kicad_sch]
2024-06-02 Some drc fixes
    [half-bridge.kicad_pcb]
2024-06-02 Change pinout and add voltage regulators to controller
    [controller.kicad_pcb, controller.kicad_sch, half-bridge.kicad_pcb, half-bridge.kicad_sch]
2024-06-02 Controller - Add labels for pin functions
    [controller.kicad_pcb, controller.kicad_sch]
2024-06-02 Fixup reference designators, more work on controller etc
    [controller.kicad_pcb, controller.kicad_sch, half-bridge.kicad_pcb, half-bridge.kicad_sch]
2024-06-02 WIP - Reduce size and bump to 6 layers
    [half-bridge.kicad_pcb, half-bridge.kicad_sch]
2024-06-02 More work on controller - Add decoupling caps for mcu etc
    [controller.kicad_pcb, controller.kicad_sch]
2024-06-02 Add wifi module
    [controller.kicad_pcb, controller.kicad_sch]
2024-06-02 Cleanup, add more cap etc
    [half-bridge.kicad_pcb, half-bridge.kicad_sch]
2024-06-02 Update BOM
    [half-bridge.kicad_sch]
2024-06-02 Use kicad 8
2024-06-02 Increase via size
    [half-bridge.kicad_pcb, half-bridge.kicad_sch]
2024-06-02 Fix more ERC and DRC errors and warnings
    [half-bridge.kicad_pcb, half-bridge.kicad_sch]
2024-06-02 Improve via placement
    [half-bridge.kicad_pcb]
2024-06-02 Change some remaining vias to 0.45/0.3mm
    [half-bridge.kicad_pcb]
2024-06-02 Attempt to slightly improve isolation distance
    [half-bridge.kicad_pcb]
2024-06-02 Larger via size in lmg1210 footprint
2024-06-02 Dont use custom 3D model for MLCC
    [half-bridge.kicad_pcb]
2024-06-24 Fix kicost
    [half-bridge.kicad_pcb, half-bridge.kicad_sch]
2024-06-24 Add extra OP, close hole in planes under switch node
    [half-bridge.kicad_pcb, half-bridge.kicad_sch]
2024-06-24 Add layers for a total of 8 copper layers. Add comments in silkscreen and some test points
    [half-bridge.kicad_pcb, half-bridge.kicad_sch]
2024-12-15 Controller - Lots of changes
    [controller.kicad_pcb, controller.kicad_sch]
2024-12-15 FW - stm32g4 - Add code
2024-12-15 More work on controller
    [controller.kicad_pcb, controller.kicad_sch]
2024-12-15 Add hierarchial sheets
    [dual_switch.kicad_sch]
2024-12-15 Probably nothing
    [controller.kicad_sch]
2024-12-15 Controller - More changes
    [controller.kicad_pcb, controller.kicad_sch, dual_high_side_fet.kicad_sch, mcu_clamp.kicad_sch]
2024-12-15 Remove USB CC protections
    [48_to_3v3_divider.kicad_sch, controller.kicad_pcb, controller.kicad_sch, mcu_clamp.kicad_sch]
2024-12-15 Controller - Try to simplify
    [48_to_3v3_divider.kicad_sch, controller.kicad_pcb, controller.kicad_sch, hb-card.kicad_sch, mcu_clamp.kicad_sch]
2024-12-15 Controller - More work mainly on layout
    [48_to_3v3_divider.kicad_sch, controller.kicad_pcb, controller.kicad_sch, hb-card.kicad_sch]
2024-12-15 Break out ESP to sub circuit
    [controller.kicad_sch]
2024-12-15 Controller move DC/DC to between HB4 and HB5
    [clf7045ni-d.step, controller.kicad_pcb, controller.kicad_sch, esp32c6.kicad_sch]
2024-12-15 Firmware - Update some WIP work on regulator etc.
2024-12-15 Controller - Route extra usb's CC-pins and some other pins to pin header
    [controller.kicad_sch]
2024-12-15 Controller - Some smaller changes, add 3d models etc
    [QFN-6L_STM.step, controller.kicad_pcb, controller.kicad_sch]
2024-12-15 Update some pin names
2024-12-15 Controller and firwmare most pins in sync
    [controller.kicad_pcb, controller.kicad_sch]
2024-12-15 More work on pins (Controller and firwmare)
    [controller.kicad_sch]
2024-12-15 Controller - Some more pin related changes
    [controller.kicad_sch]
2024-12-15 Controller - All currents can now be read by ADCs
    [controller.kicad_sch]
2024-12-15 Controller - some more changes
    [48_to_3v3_divider.kicad_sch, CLMUD-FKC-CH1NP1561BB7T4S3.stp, controller.kicad_pcb, controller.kicad_sch, esp32c6.kicad_sch, hb-card.kicad_sch]
2024-12-15 Controller - Route mcu pins
    [controller.kicad_pcb, controller.kicad_sch]
2024-12-15 Controller - Route more mcu pins
    [controller.kicad_pcb]
2024-12-15 Controller - Even more pins
    [controller.kicad_pcb, controller.kicad_sch, esp32c6.kicad_sch]
2024-12-15 Controller - Start work on vbus connection, improve rgb-led placement
    [controller.kicad_pcb, controller.kicad_sch, hb-card.kicad_sch]
2024-12-15 Controller - Setup clearance, place rgb led resistors, some more routing and step down current sense
    [controller.kicad_pcb, controller.kicad_sch]
2024-12-15 Half Bridge - Change current sensor
    [half-bridge.kicad_pcb, half-bridge.kicad_sch]
2024-12-15 Controller - Change current sensor
    [controller.kicad_pcb, controller.kicad_sch, hb-card.kicad_sch]
2024-12-15 Controller - More routing
    [48_to_3v3_divider.kicad_sch, controller.kicad_pcb, controller.kicad_sch, hb-card.kicad_sch]
2024-12-15 Controller - Expand to 100x40mm
    [controller.kicad_pcb, controller.kicad_sch]
2024-12-15 Add current sensor
    [ACS37030LLZATR-020B3.stp]
2024-12-15 Add step for inductance
    [CLF7045NIT-4R7N-D.STEP, clf7045ni-d.step, controller.kicad_pcb]
2024-12-15 Controller - Some changes
    [controller.kicad_pcb]
2024-12-15 Add new led
    [controller.kicad_pcb, controller.kicad_sch]
2024-12-15 Add new leds
    [controller.kicad_pcb, controller.kicad_sch, esp32c6.kicad_sch]
2024-12-15 Controller - Expand to 100x50mm to allow VBUS to go around
    [controller.kicad_pcb, controller.kicad_sch, hb-card.kicad_sch]
2024-12-15 Controller - Lots of cleanup
    [controller.kicad_pcb, controller.kicad_sch]
2024-12-15 Controller - NTCs done
    [controller.kicad_pcb]
2024-12-15 Controller - Most things routed
    [controller.kicad_pcb, controller.kicad_sch, esp32c6.kicad_sch]
2024-12-15 Controller - Add rotary encoder
    [EC11E-05SW.STEP, RK09Y11L0001.STEP, controller.kicad_pcb, controller.kicad_sch]
2024-12-15 HB - Fix DRC errors
    [half-bridge.kicad_pcb]
2024-12-15 Controller - More work around rotary encoder and move protection diodes
    [controller.kicad_pcb, controller.kicad_sch]
2024-12-15 Controller - Fix all DRC errors and some warnings
    [controller.kicad_pcb, controller.kicad_sch, esp32c6.kicad_sch, hb-card.kicad_sch]
2024-12-15 Controller - Cleanup and improve silkscreen
    [controller.kicad_pcb, controller.kicad_sch]
2024-12-15 Half-Bridge - Fix DRC errors
    [half-bridge.kicad_pcb]
2025-05-26 bump stm32-hrtim
2025-06-06 Math still not working...
    [control.rs, mod.rs]
2025-07-08 Temp and current
2025-07-12 Add heatspreader
    [heat_spreader2.FCStd]
2025-07-31 Use probe-plotter
2025-08-04 Add plotting using probe-plotter
2025-08-04 Fix hi/lo mixup, add current limit
    [minimal.rs, mod.rs, timers.rs]
2025-08-13 Fix the math
    The math now gives the same result for the example in 'Hallworth, M. and Shirsavar, A. (2012) Microcontroller-based
    peak current mode control using digital slope compensation'
    [control.rs, mod.rs]
2026-02-21 Add support for boost and buck-boost with with lots of help from Claude
2026-03-17 Add peak current mode controlled buck converter with probe-plotter support and dynamic slope compensation - Works ok:ish
2026-03-24 Lots of changes
    * Use actual component values control math
    * Lots of fixes for slope compensation, blanking etc
    [load-test.rs, minimal.rs]
